EduardoLAV/Kinesic/README.md

# Kinesic
Platform to develop medical applications using biosignals

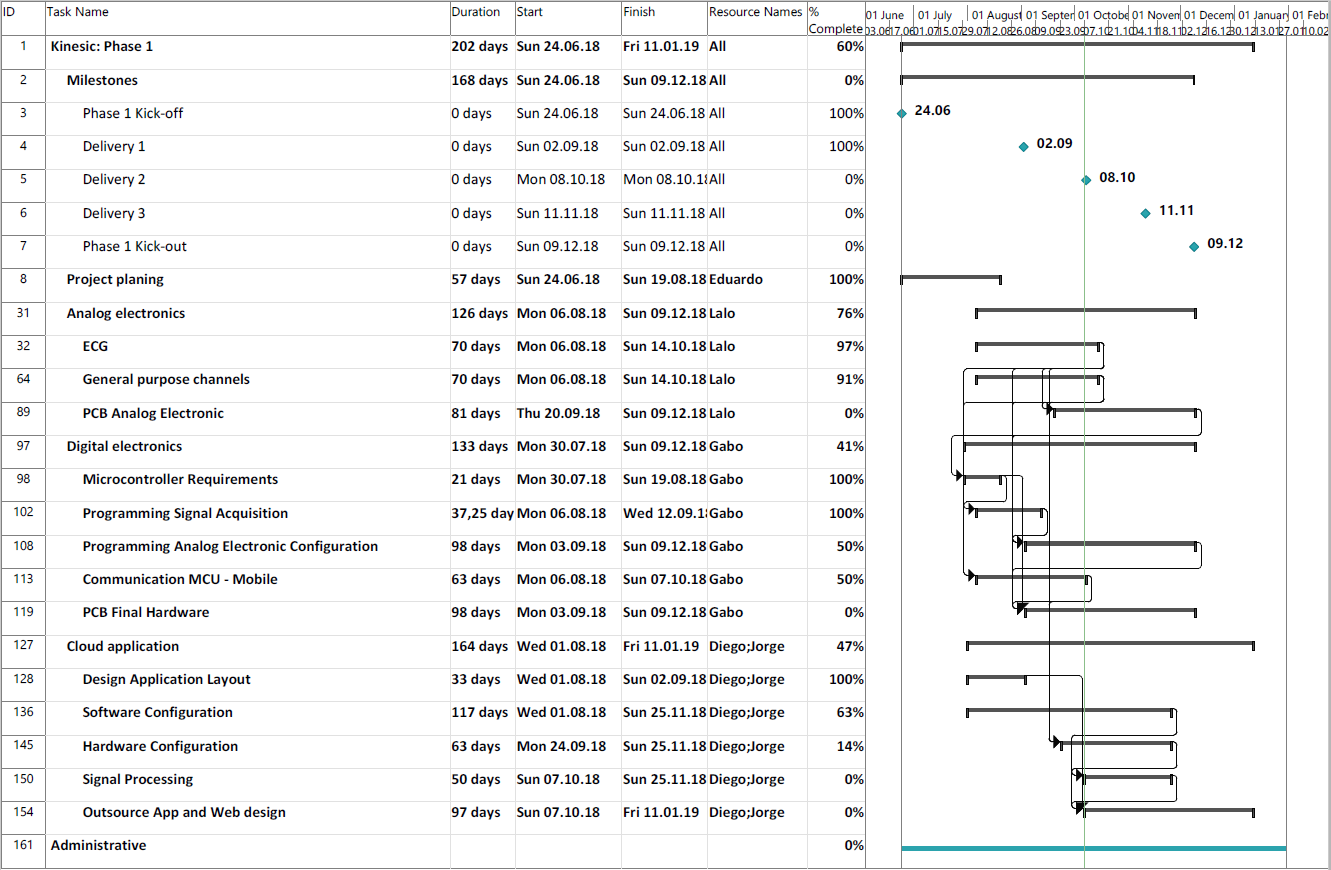
[picture p1: 10_Management/10_Planning/Kinesic_Timeline.PNG]
