EduardoLAV/Kinesic/20_Engineering/10_Analog_Electronics/Empresas PCB.docx

Nombre | Sitio Web | Localidad | Especificaciones de diseño | Formulario de cotización
Mextronics | mextronics.com | CDMX | liga (http://www.mextronics.com/index.php/produccion-de-pcb-s/especificaciones) | Mextronics cotización (http://www.mextronics.com/index.php/produccion-de-pcb-s/especificaciones)
Hetpro | hetpro-store.com | Guadalajara | Hetpro: - especificaciones (https://hetpro-store.com/fabricacionPCB/fabricacion-pcb-mexico/) - Diseño (https://hetpro-store.com/fabricacionPCB/fabricacion-pcb-mexico/) | Hetpro cotización (https://hetpro-store.com/fabricacionPCB/fabricacion-pcb-mexico/)
Grupo Gollet Electronics | gollet.com.mx | Guadalajara | | (01)(33) 3810-6501, 3810-6502, 3343 9945
PCB rápido | pcbrapido.com | Querétaro | PCBRápido (http://pcbrapido.com/producto/placa-intel/) | PCBR (http://pcbrapido.com/cotiza/)
Easy circuits | easycircuits.com.mx | CDMX
Tinxo electronic design | Tinxo.mx | Guadalajara | | Servicios (http://tinxo.mx/servicios/)
Electrónica estudio | electronicaestudio.com | CDMX | Servicios (http://www.electronicaestudio.com/ingenieria.htm)
