EduardoLAV/Kinesic/20_Engineering/10_Analog_Electronics/10_Planning/Gantt_Analog_Electronics.xlsx

ID | Task | Status | Start Date | Due Date | Duration | Y | 2018
 |  |  |  |  |  | M | Jun |  | Jul |  |  |  |  | Aug |  |  |  | Sep |  |  |  | Oct |  |  |  |  | Nov |  |  |  | Dec
 |  |  |  |  |  | CW | 25 | 26 | 27 | 28 | 29 | 30 | 31 | 32 | 33 | 34 | 35 | 36 | 37 | 38 | 39 | 40 | 41 | 42 | 43 | 44 | 45 | 46 | 47 | 48 | 49 | 50 | 51 | 52 | 53
2.1 | ECG
2.1.1 | Preamplification | Doing | 2018-08-06 | 2018-08-19 | 13
2.1.1.1 | Identify gain ranges for pre-amplification | Closed | 2018-08-06 | 2018-08-19 | 13
2.1.1.2 | Define instrumental amplifier to be used 12/08/2018: AD620 | Closed | 2018-08-06 | 2018-08-12 | 6
2.1.1.3 | Calculate needed ranges of digital potentiometers | Closed | 2018-08-06 | 2018-08-19 | 13
2.1.1.4 | Identify and buy digital potentiomet. and InsAmp. | Closed | 2018-08-06 | 2018-08-19 | 13
2.1.1.5 | Build preamplification circuit in protoboard | Closed | 2018-08-06 | 2018-08-19 | 13
2.1.1.6 | Test preamplification circuit | Open | 2018-09-13 | 2018-09-19 | 6
2.1.1.7 | Define final potentiomet. and InsAmp. to be used | Open | 2018-09-13 | 2018-09-19 | 6
2.1.2 | Multiplexer | Doing | 2018-09-03 | 2018-09-30 | 27
2.1.2.1 | Research types of analog multiplexers | Doing | 2018-09-01 | 2018-09-13 | 12
2.1.2.2 | Identify and order 3 analog multiplexers | Open | 2018-09-03 | 2018-09-15 | 12
2.1.2.3 | Receive multiplexer | Open | 2018-09-05 | 2018-09-17 | 12
2.1.2.4 | Build multiplexer + preamplification in protoboard | Open | 2018-09-08 | 2018-09-22 | 14
2.1.2.5 | Test signal quality with multiplexer | Open | 2018-09-18 | 2018-09-23 | 5
2.1.2.6 | Verify maximum signal frequency with multiplexer | Open | 2018-09-18 | 2018-09-23 | 5
2.1.2.7 | Define multiplexer to be used | Open | 2018-09-23 | 2018-09-30 | 7
2.1.3 | Filters | Doing | 2018-08-13 | 2018-09-30 | 48
2.1.3.1 | Identify frequency ranges for biosignals | Closed | 2018-08-13 | 2018-08-26 | 13
2.1.3.2 | Design cut-band filter at 60Hz | Closed | 2018-08-13 | 2018-08-26 | 13
2.1.3.3 | Identify and buy digital pot. for all frequency ranges | Closed | 2018-08-20 | 2018-09-02 | 13
2.1.3.4 | Build filter + multiplexer + preamp. in protoboard | Open | 2018-09-08 | 2018-09-22 | 14
2.1.3.5 | Test filters | Open | 2018-09-22 | 2018-09-25 | 3
2.1.3.6 | Define components for filter circuit | Open | 2018-09-24 | 2018-09-25 | 1
2.1.4 | Final Amplification | Open | 2018-09-10 | 2018-09-30 | 20
2.1.4.1 | Identify gain ranges for final amplification | Closed | 2018-09-10 | 2018-09-16 | 6
2.1.4.2 | Calculate needed ranges of digital potentiometers | Closed | 2018-09-10 | 2018-09-16 | 6
2.1.4.3 | Identify and buy digital potentiometers | Doing | 2018-09-10 | 2018-09-23 | 13
2.1.4.4 | Build amp+filter+multiplexer+preamp in protoboard | Open | 2018-09-24 | 2018-09-30 | 6
2.1.4.5 | Test amplification circuit | Open | 2018-09-24 | 2018-09-30 | 6
2.1.4.6 | Define digital potentiometers to be used | Open | 2018-09-24 | 2018-09-30 | 6
2.2 | General purpose channels
2.2.1 | Preamplification | Doing | 2018-08-06 | 2018-08-19 | 13
2.2.1.1 | Identify gain ranges for pre-amplification | Closed | 2018-08-06 | 2018-08-19 | 13
2.2.1.2 | Define instrumental amplifier to be used 12/08/2018: AD620 | Closed | 2018-08-06 | 2018-08-12 | 6
2.2.1.3 | Calculate needed ranges of digital potentiometers | Closed | 2018-08-06 | 2018-08-19 | 13
2.2.1.4 | Identify and buy digital potentiomet. and InsAmp. | Closed | 2018-08-06 | 2018-08-19 | 13
2.2.1.5 | Build preamplification circuit in protoboard | Closed | 2018-08-06 | 2018-08-19 | 13
2.2.1.6 | Test preamplification circuit | Open | 2018-09-08 | 2018-09-15 | 7
2.2.1.7 | Define final potentiomet. and InsAmp. to be used | Open | 2018-09-14 | 2018-09-16 | 2
2.2.2 | Filters | Doing | 2018-08-13 | 2018-09-30 | 48
2.2.2.1 | Identify frequency ranges for biosignals | Closed | 2018-08-13 | 2018-08-26 | 13
2.2.2.2 | Calculate ranges of digital pot. for low-pass filters | Doing | 2018-09-13 | 2018-09-12 | 0
2.2.2.3 | Calculate ranges of digital pot. for high-pass filters | Closed | 2018-08-13 | 2018-08-26 | 13
2.2.2.4 | Design cut-band filter at 60Hz | Closed | 2018-08-13 | 2018-08-26 | 13
2.2.2.5 | Identify and buy digital pot. for all frequency ranges | Doing | 2018-08-28 | 2018-09-15 | 18
2.2.2.6 | Build filter + multiplexer + preamp. in protoboard | Open | 2018-09-16 | 2018-10-05 | 19
2.2.2.7 | Test filters with different frequency ranges | Open | 2018-09-20 | 2018-10-06 | 16
2.2.2.8 | Define components for filter circuit | Open | 2018-10-05 | 2018-10-07 | 2
2.2.4 | Final Amplification | Open | 2018-09-10 | 2018-10-07 | 27
2.2.4.1 | Identify gain ranges for final amplification | Closed | 2018-09-10 | 2018-09-16 | 6
2.2.4.2 | Calculate needed ranges of digital potentiometers | Closed | 2018-09-10 | 2018-09-16 | 6
2.2.4.3 | Identify and buy digital potentiometers | Doing | 2018-09-10 | 2018-09-23 | 13
2.2.4.4 | Build amp+filter+multiplexer+preamp in protoboard | Open | 2018-09-24 | 2018-10-02 | 8
2.2.4.5 | Test amplification circuit | Open | 2018-09-24 | 2018-10-05 | 11
2.2.4.6 | Define digital potentiometers to be used | Open | 2018-09-24 | 2018-10-06 | 12
2.3 | PCB Analog Electronic | Open | 2018-09-03 | 2018-12-09 | 97
2.3.1 | Design PCB eschematics | Open | 2018-10-13 | 2018-10-19 | 6
2.3.2 | Create electronic/PCB layout | Open | 2018-10-20 | 2018-10-28 | 8
2.3.3 | Contact 5 suppliers to manufacture prototype | Open | 2018-09-20 | 2018-10-20 | 30
2.3.4 | Receive 3 RFQs | Open | 2018-10-01 | 2018-10-28 | 27
2.3.5 | Perform PO | Open | 2018-10-22 | 2018-11-18 | 27
2.3.6 | Receive PCB prototype | Open | 2018-11-19 | 2018-11-25 | 6
2.3.7 | Validate prototype | Open | 2018-11-26 | 2018-12-09 | 13
