EduardoLAV/Kinesic/20_Engineering/10_Analog_Electronics/Entrega/Sobre documentos de Eagle.docx

Sobre documentos de Eagle.

Se cargaron los documentos de los archivos Eagle en un Zip. En cada Zip se encuentran muchos archivos. El .sch corresponde al esquemático. El .brd, corresponde al board. Dichos documentos fueron creados en la versión 9.0.0 de Eagle, sin embargo, pueden ser utilizados en versiones posteriores.

Los documentos Eagle se dividen en dos opciones:

1. Opción de una sola placa 10x15 cm a doble cara.

Los archivos relacionados con este diseño son los que tienen por nombre “Placa 1”.

2. Opción de dos placas “Primera” y “Segunda”.

Primera: 10x10 cm, etapa de adquisición, amplificación diferencial y aislamiento.

Segunda: 10x15 cm, filtrado y amp. Variable

A parte de los zip, se subió un .pdf con los esquemáticos para poder visualizarlos en modo PDF.
