EduardoLAV/Kinesic/10_Management/50_Market/Statistics/global_medical_alert_market_2013_2020.pdf

M

ark

et v

olu

m

e in

billio

n

U.S. d

ollars

Global medical alert systems/PERS market volume between 2013 and 2020 (in billion U.S. dollars)*

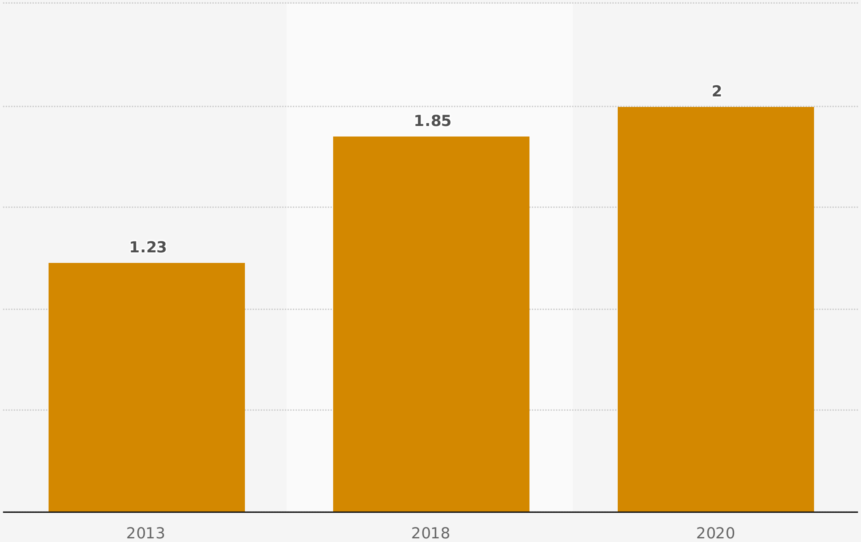
[picture p15: figure]

Additional Information:
Worldwide

Source
IndustryARC
© Statista 2018

0

0.5

1

1.5

2

2.5
