EduardoLAV/Kinesic/20_Engineering/20_Digital_Electronics/10_Planning/Gantt_Digital_Electronics.xlsx

ID | Task | Status | Start Date | Due Date | Duration | Y | 2018 |  |  |  |  |  |  |  |  |  |  |  |  |  |  |  |  |  |  |  |  |  |  |  |  |  |  |  |  | Open | 20 | 66.67%
 |  |  |  |  |  | M | Jun |  | Jul |  |  |  |  | Aug |  |  |  | Sep |  |  |  | Oct |  |  |  |  | Nov |  |  |  | Dec |  |  |  |  | Doing | 9 | 30.00%
 |  |  |  |  |  | CW | 25 | 26 | 27 | 28 | 29 | 30 | 31 | 32 | 33 | 34 | 35 | 36 | 37 | 38 | 39 | 40 | 41 | 42 | 43 | 44 | 45 | 46 | 47 | 48 | 49 | 50 | 51 | 52 | 53 | Closed | 1 | 3.33%
3. | Digital Electronics | Doing | 2018-07-30 | 2018-12-09 | 132
3.1 | Microcontroller Requirements | Doing | 2018-07-30 | 2018-08-19 | 20
3.1.1 | Define inputs needed for signal acquisition | Doing | 2018-08-06 | 2018-08-19 | 13
3.1.2 | Define outputs needed for digital potentiometers | Open | 2018-08-06 | 2018-08-19 | 13
3.1.3 | Decide on communication protocol - MCU & Mobile 12/08/2018: Bluetooth | Closed | 2018-07-30 | 2018-08-12 | 13
3.2 | Programming Signal Acquisition | Doing | 2018-08-06 | 2018-09-02 | 27
3.2.1 | Program signal acquisition in MCU | Doing | 2018-09-06 | 2018-09-12 | 6
3.2.2 | Design and implement signal validation tool | Open | 2018-08-06 | 2018-08-19 | 13
3.2.3 | Test signal acquisition by using standard signals | Open | 2018-08-13 | 2018-08-19 | 6
3.2.4 | Program signal acquisition using multiplexer | Open | 2018-08-13 | 2018-08-26 | 13
3.2.5 | Test signal acquisition by using standard signals | Open | 2018-08-27 | 2018-09-02 | 6
3.3 | Programming Analog Electronic Configuration | Doing | 2018-09-03 | 2018-12-09 | 97
3.3.1 | Set base config. for acquisition of standard signals | Doing | 2018-09-03 | 2018-09-30 | 27
3.3.2 | Test base configuration by using standard signals | Open | 2018-10-01 | 2018-10-07 | 6
3.3.3 | Test base config. with electronic from protoboard | Open | 2018-10-01 | 2018-10-07 | 6
3.3.4 | Test base config. with PCB analog electronic | Open | 2018-11-26 | 2018-12-09 | 13
3.4 | Communication MCU - Mobile | Doing | Doing | 2018-10-07 | #VALUE!
3.4.1 | Identify and order communication module | Doing | 2018-08-06 | 2018-08-19 | 13
3.4.2 | Program communication between MCU & Mobile | Open | 2018-08-13 | 2018-09-02 | 20
3.4.3 | Test communication by sending dummy sequences | Open | 2018-09-03 | 2018-09-16 | 13
3.4.4 | Test communication by sending known signal | Open | 2018-09-03 | 2018-09-16 | 13
3.4.5 | Test communication by sending biosignals | Open | 2018-10-01 | 2018-10-07 | 6
3.5 | PCB Final Hardware | Open | 2018-09-03 | 2018-12-09 | 97
3.5.1 | Select MCU that covers requirements | Open | 2018-09-03 | 2018-09-16 | 13
3.5.2 | Design PCB layout with analog electronics | Open | 2018-09-10 | 2018-10-14 | 34
3.5.3 | Contact 5 suppliers to manufacture prototype | Open | 2018-09-03 | 2018-09-30 | 27
3.5.4 | Receive 3 RFQs | Open | 2018-10-01 | 2018-10-28 | 27
3.5.5 | Perform PO | Open | 2018-10-22 | 2018-11-18 | 27
3.5.6 | Receive PCB prototype | Open | 2018-11-19 | 2018-11-26 | 7
3.5.7 | Validate prototype | Open | 2018-11-27 | 2018-12-09 | 12
