EduardoLAV/Kinesic/30_Supplier_Management/10_RFQ/README.md

Requests for quotation will be saved here independently of the application area: analog and digital electronics, web page, cloud application, etc.
