EduardoLAV/Kinesic/30_Supplier_Management/20_Quotes/README.md

Quotes received from suppliers to be saved here
