EduardoLAV/Kinesic/10_Management/20_Finance/10_Accounting/expense-tracking.xlsx

Sheet: Expenses
Expense Tracking
 |  |  |  |  |  |  |  |  | © 2009-2014 Vertex42 LLC
 |  | Budget |  |  |  |  |  | 31446.22 | https://www.vertex42.com/ExcelTemplates/expense-tracker.html
 |  | % Spent | - | - | - | - | - | 0.0%
 |  | Remaining | 0 | 0 | 0 | 0 | 0 | 31446.22
 |  |  |  |  |  |  |  | [42]
Date | Payment Type | Description | Analog Electronics | Digital Electronics | Interface MCU-Mobile | Cloud Solution | Other | Subtotal
 |  |  |  |  |  |  |  | 0.00
 |  |  |  |  |  |  |  | 0.00
 |  |  |  |  |  |  |  | 0.00
 |  |  |  |  |  |  |  | 0.00
 |  |  |  |  |  |  |  | 0.00
 |  |  |  |  |  |  |  | 0.00
 |  |  |  |  |  |  |  | 0.00
 |  |  |  |  |  |  |  | 0.00
 |  |  |  |  |  |  |  | 0.00
 |  |  |  |  |  |  |  | 0.00
 |  |  |  |  |  |  |  | 0.00
 |  |  |  |  |  |  |  | 0.00
 |  |  |  |  |  |  |  | 0.00
 |  |  |  |  |  |  |  | 0.00
 |  |  |  |  |  |  |  | 0.00
 |  |  |  |  |  |  |  | 0.00
 |  |  |  |  |  |  |  | 0.00
 |  |  |  |  |  |  |  | 0.00
 |  |  |  |  |  |  |  | 0.00
 |  |  |  |  |  |  |  | 0.00
 |  |  |  |  |  |  |  | 0.00
 |  |  |  |  |  |  |  | 0.00
 |  |  |  |  |  |  |  | 0.00
 |  |  |  |  |  |  |  | 0.00
 |  |  |  |  |  |  |  | 0.00
 |  |  |  |  |  |  |  | 0.00
 |  |  |  |  |  |  |  | 0.00
 |  |  |  |  |  |  |  | 0.00
 |  |  |  |  |  |  |  | 0.00
 |  |  |  |  |  |  |  | 0.00
 |  | Expense Total | 0.00 | 0.00 | 0.00 | 0.00 | 0.00 | 0.00

Sheet: ©
Expense Tracking Template
By Vertex42.com
https://www.vertex42.com/ExcelTemplates/expense-tracker.html
© 2009-2014 Vertex42 LLC
This spreadsheet, including all worksheets and associated content is a copyrighted work under the United States and other copyright laws.
Do not submit copies or modifications of this template to any website or online template gallery.
Please review the following license agreement to learn how you may or may not use this template. Thank you.
https://www.vertex42.com/licensing/EULA_privateuse.html
Do not delete this worksheet
