EduardoLAV/Kinesic/10_Management/50_Market/Statistics/ehealth_heart_failure_revenue_ww_2017.pdf

## Revenue of eHealth solutions for heart failure in selected countries worldwide in 2017* (in million U.S. dollars)

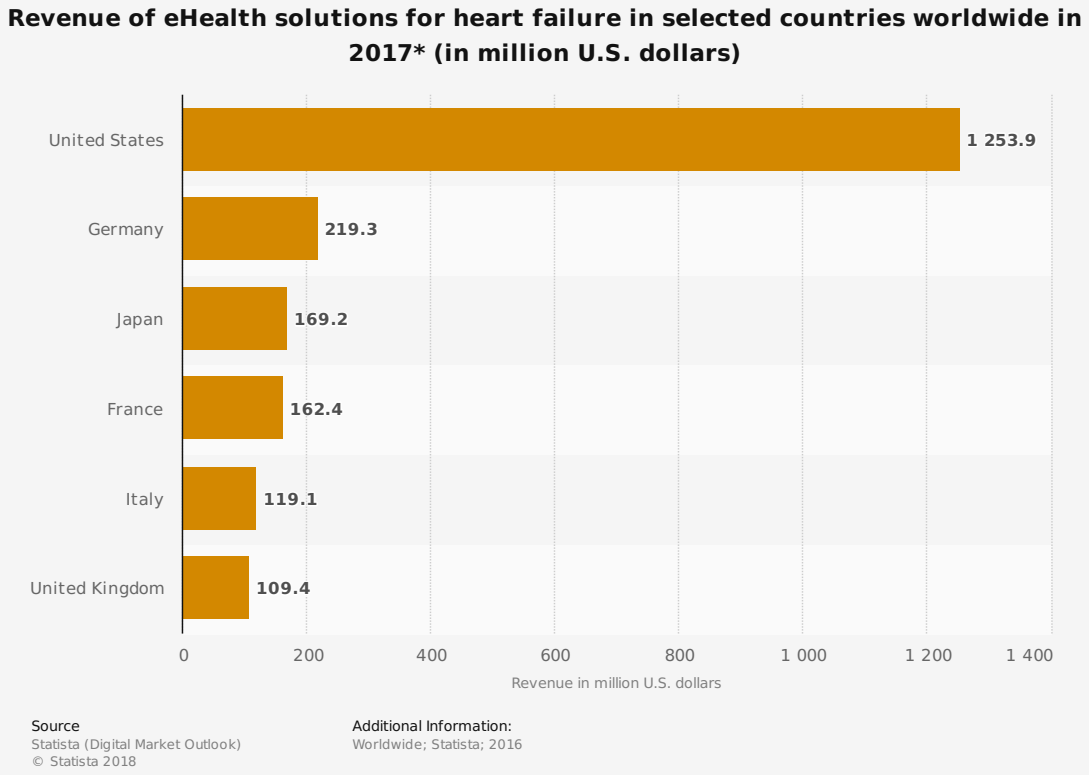
[picture p16: page 1]
Additional Information: Worldwide; Statista; 2016; United States; Germany; Japan; France; Italy; United Kingdom

Revenue in million U.S. dollars

Source
Statista (Digital Market Outlook)
© Statista 2018
