EduardoLAV/Kinesic/20_Engineering/10_Analog_Electronics/Entrega/Placa 1.pdf

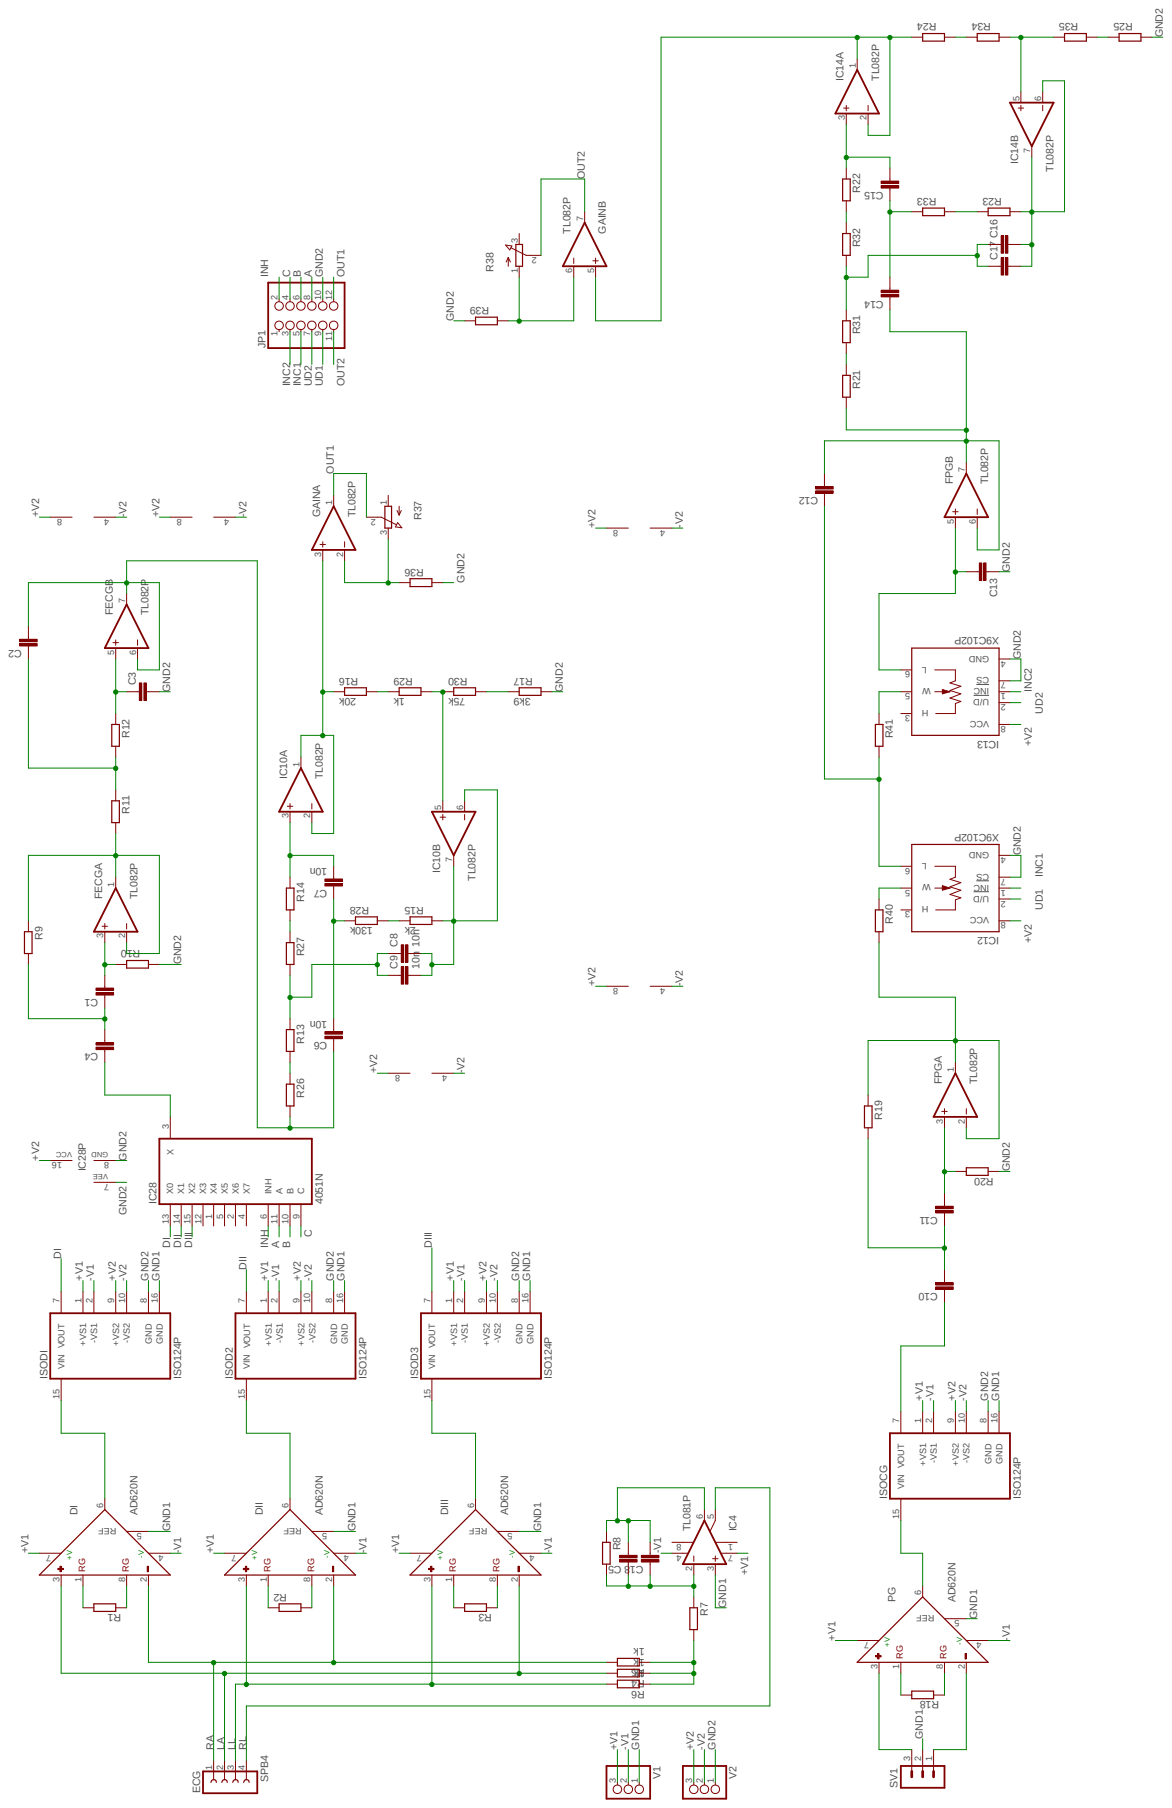
[picture p17: page 1]

1 R40 R41 JP11 2 3 4 5 6 7 8 9 10 11 12 C18 RALLRL GND1 GND1 GND1 GND1 GND1 GND1 GND1 GND1 GND1 GND1 GND1 GND2 GND2 GND2 GND2 GND2 GND2 GND2 GND2 GND2 GND2 GND2 GND2 GND2 GND2 GND2 GND2 GND2 GND2 +V1 +V1 +V1 +V1 +V1 +V1 +V1 +V1 +V1 +V1 -V1 -V1 -V1 -V1 -V1 -V1 -V1 -V1 -V1 -V1 +V2 +V2 +V2 +V2 +V2 +V2 +V2 +V2 +V2 +V2 +V2 +V2 +V2 -V2 -V2 -V2 -V2 -V2 -V2 -V2 -V2 -V2 -V2 DIDI DII DII DIII DIII LA OUT1 OUT1 OUT2 UD1 OUT2 UD1 UD2 UD2 INC1 INC1

A INH INH INC2 INC2 RGRGRGRGRGRG RGRG +V-V+V-V+V-V +V-V
