EduardoLAV/Kinesic/20_Engineering/10_Analog_Electronics/Entrega/Primera_pdf.pdf

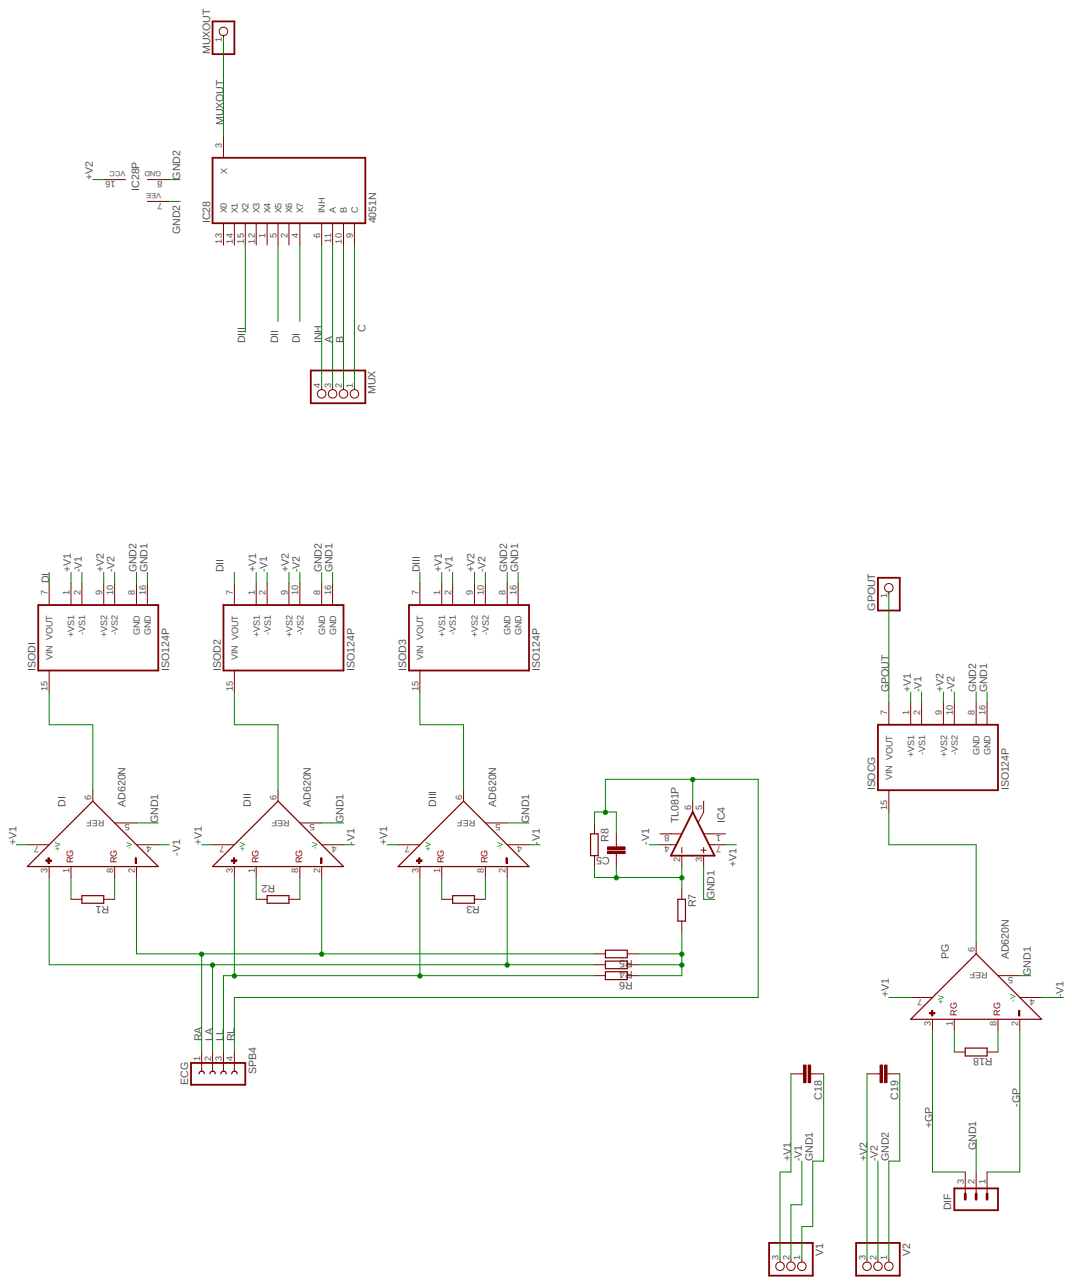
[picture p18: page 1]
AD620N AD620N AD620N TL081P ISO124P ISO124P ISO124P SPB4 AD620N ISO124P 4051N DI 3; 8 REF 5 DII 3; 8 REF 5 DIII 3; 8 REF 5 IC45; 9 -VS2 10 GND; 8 GND 16; 8 GND 16 IC28X4 1 X6; 5 INH; 9 B 10 A 11 X3 12 X0 13 X1 14 X2 15 DIF; 1 MUX 4; C INH

B GPOUT MUXOUT RGRGRGRGRGRG RGRG +V-V+V-V+V-V +V-V

1 GPOUT 1 RALLRL GND1 GND1 GND1 GND1 GND1 GND1 GND1 GND1 GND1 GND1 GND1 GND2 GND2 GND2 GND2 GND2 GND2 GND2 +V1 +V1 +V1 +V1 +V1 +V1 +V1 +V1 +V1 +V1 -V1-V1 -V1 -V1 -V1 -V1 -V1 -V1 -V1 -V1 +V2 +V2 +V2 +V2 +V2 +V2 -V2 -V2 -V2 -V2 -V2 DI DI DII DII DIII DIII LA +GP-GP

8 GND 16 ISOD2 VIN 15 VOUT

8 GND 16 ISOD3 VIN 15 VOUT

8 REF 5 R18 ISOCG VIN 15 VOUT
