EduardoLAV/Kinesic/20_Engineering/10_Analog_Electronics/Entrega/Segunda_pdf.pdf

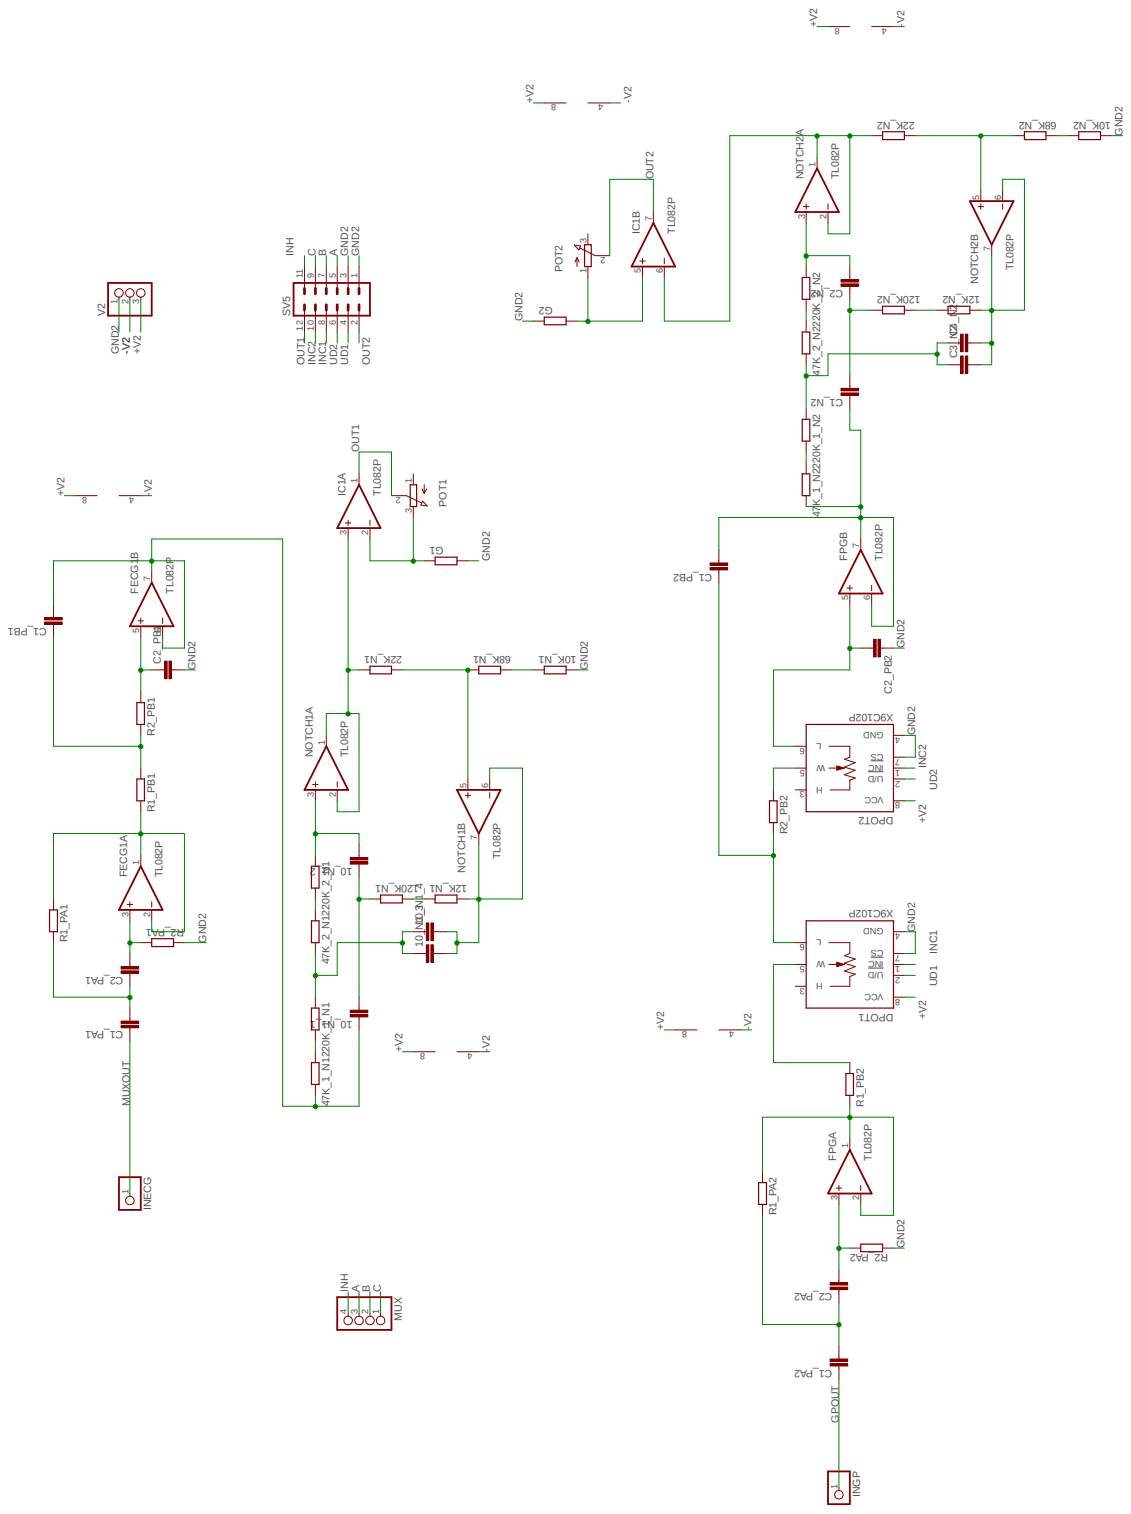
[picture p19: page 1]
C2_PA1 C1_PB1 C2_PB1 C1_PA1 R1_PA1 R2_PA1R1_PB1 R2_PB1 FECG1A 32 1 FECG1B 56 7 NOTCH1A 32 1 NOTCH1B 56 7 8 4 8 4 220K_1_N1 220K_2_N1 10_N1_1; 68K_N1 G1 POT11 3 2 SV5 531 642 1197 81210; C1_PA2 C2_PA2 FPGA 32 1 FPGB 56 7 8 4 R1_PA2 R2_PA2; C1_PB2 C2_PB2 DPOT1 U/D 2

68K_N2 POT2 1 3 2 G2 R1_PB2 R2_PB2 V2123 INECG1 INGP 1 MUX 4321 IC1A 32 1 IC1B 56 7 8 4 GND2 GND2 GND2 GND2 GND2 GND2 GND2 GND2 GND2 GND2 GND2 GND2 GND2 +V2 +V2 +V2 +V2+V2 +V2 +V2 +V2 -V2 -V2 -V2 -V2 -V2 -V2 MUXOUT OUT1 OUT1 OUT2 OUT2 UD1 UD1 UD2 UD2 INC1 INC1 C C B B A A INH INH INC2 INC2 GPOUT

INC 1 CS 7 VCC 8 GND 4 H 3 W 5 L 6NOTCH2A 32 1 NOTCH2B 56 7 8 4 47K_1_N2 220K_2_N2 C1_N2 C2_N2 C4_N2 C3_N2

INC 1 CS 7 VCC 8 GND 4 H 3 W 5 L 6 DPOT2 U/D 2
