EduardoLAV/Kinesic/10_Management/50_Market/Statistics/ehealth_revenue_EU_2018.pdf

## eHealth revenue in selected European countries in 2018 (in million U.S. dollars)

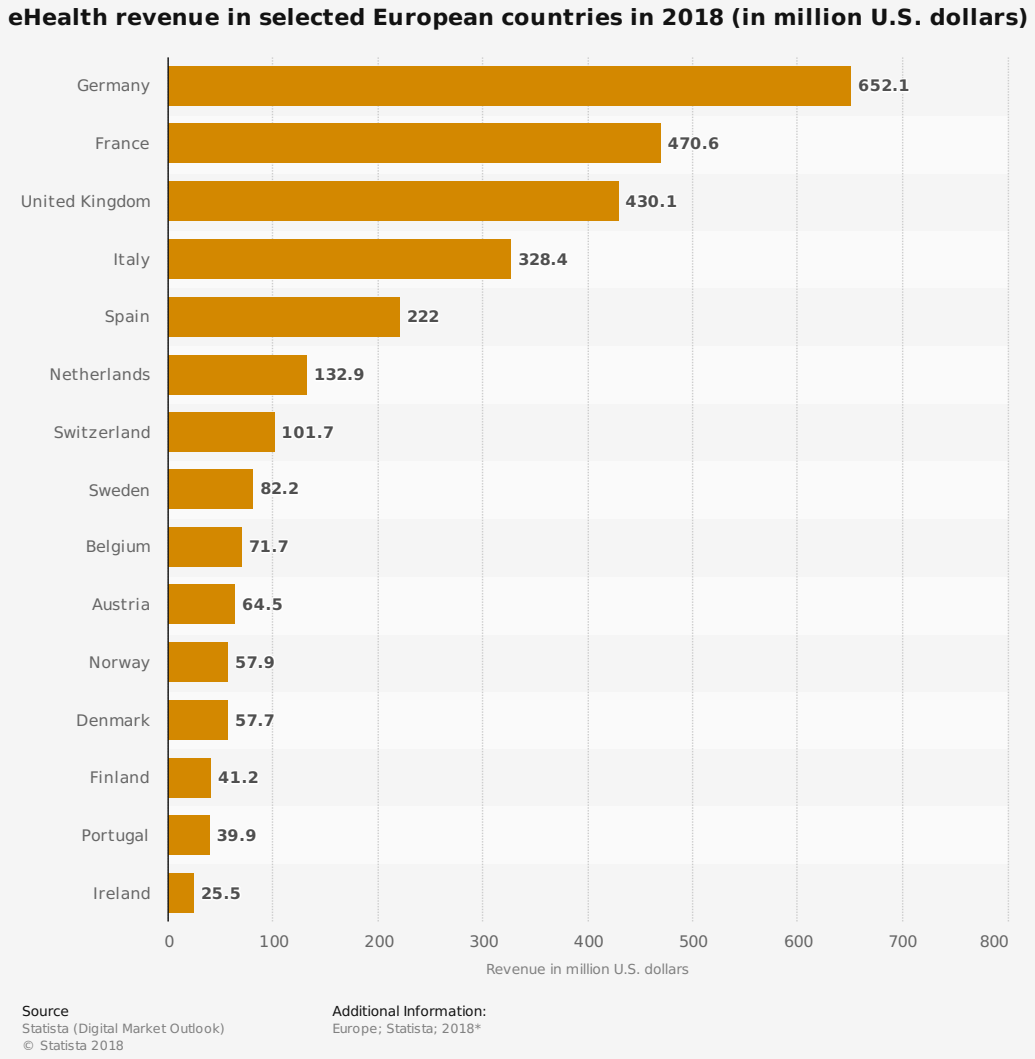
[picture p20: page 1]
Additional Information: Europe; Statista; 2018*; Germany; France; United Kingdom; Italy; Spain; Netherlands; Switzerland; Sweden; Belgium; Austria; Norway; Denmark; Finland; Portugal; Ireland

Revenue in million U.S. dollars

Source
Statista (Digital Market Outlook)
© Statista 2018
