EduardoLAV/Kinesic/10_Management/50_Market/Statistics/global_mhealth_devices_and_services_revenue_2014_2020.pdf

35.8

# Projected total global mHealth devices and services revenue from 2014 to 2020

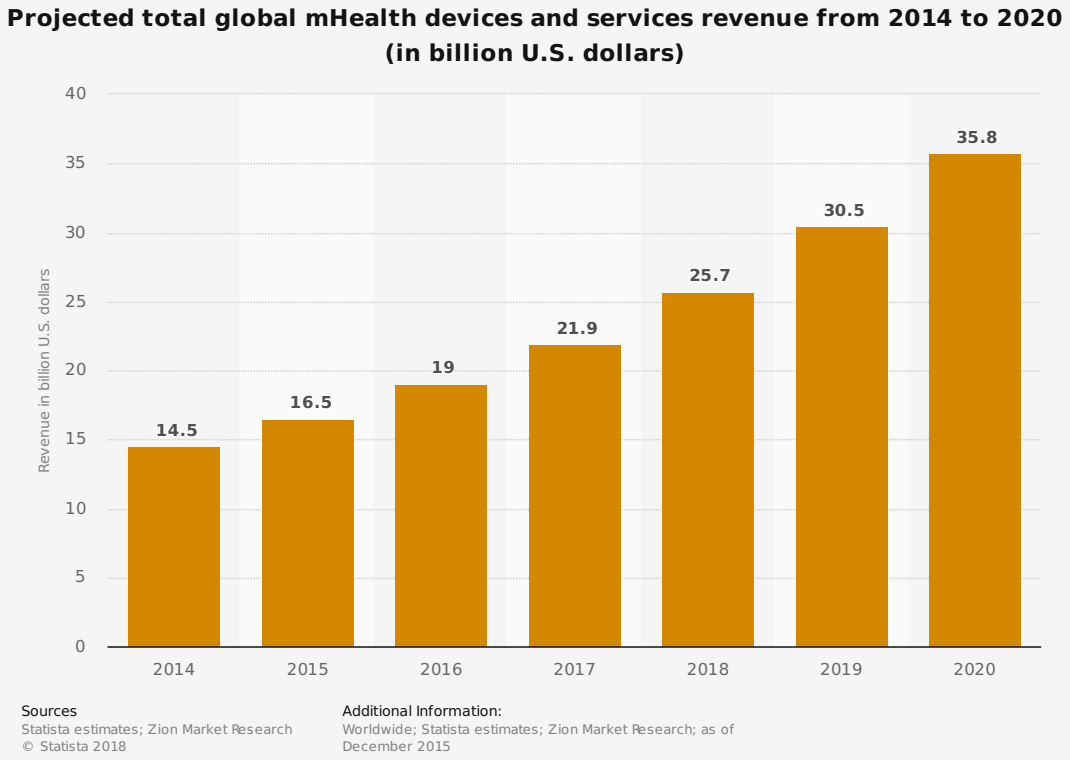
[picture p21: page 1]
billio; ollars

(in billion U.S. dollars)

Sources
Statista estimates; Zion Market Research
© Statista 2018

Additional Information:
Worldwide; Statista estimates; Zion Market Research; as of
December 2015
