EduardoLAV/Kinesic/10_Management/50_Market/Statistics/revenue_digital_health_startups_EU_2016.pdf

## Share of digital health startups revenues in the European Union in 2016

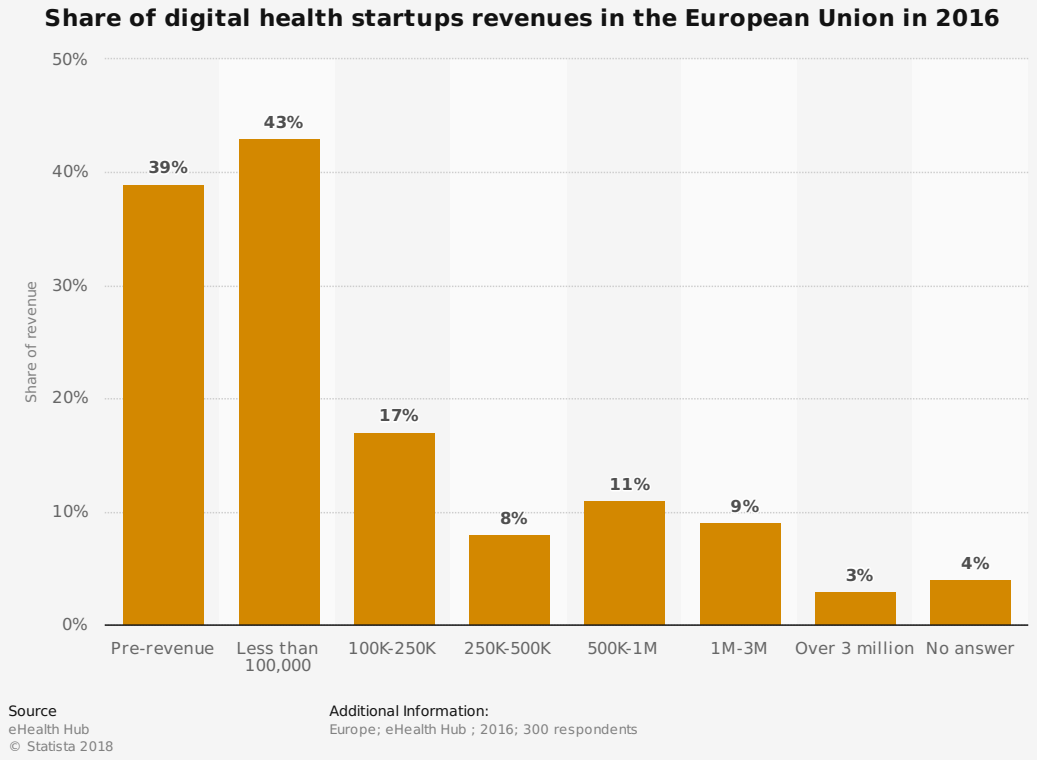
[picture p22: page 1]
are; Over 3 million No answer; Source eHealth Hub © Statista 2018

Pre-revenue Less than

Additional Information:
Europe; eHealth Hub ; 2016; 300 respondents
