EduardoLAV/Kinesic/10_Management/50_Market/Statistics/ehealth_heart-failure_penetration_EU_2016.pdf

## Usage penetration of eHealth solutions for heart failure in European countries in

2016

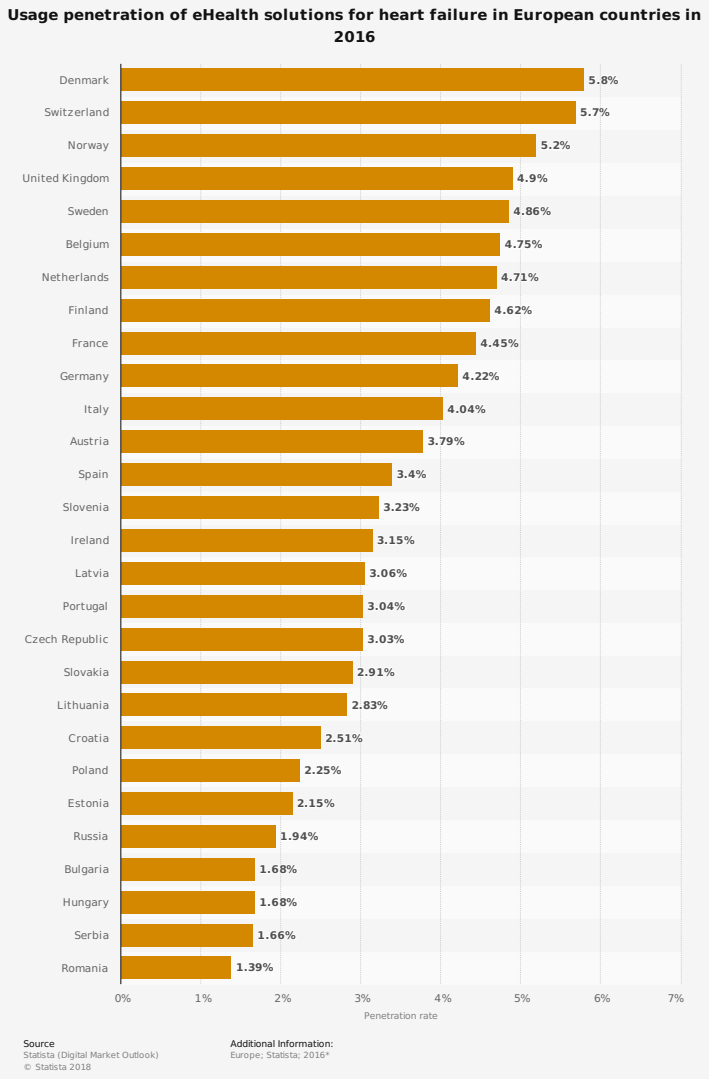
[picture p23: page 1]
Penetration rate; Additional Information: Europe; Statista; 2016*; Denmark; Switzerland; Norway; United Kingdom; Sweden; Belgium; Netherlands; Finland; France; Germany; Italy; Austria; Spain; Slovenia; Ireland; Latvia; Portugal; Czech Republic; Slovakia; Lithuania; Croatia; Poland; Estonia; Russia; Bulgaria; Hungary; Serbia; Romania

Source
Statista (Digital Market Outlook)
© Statista 2018
