EduardoLAV/Kinesic/10_Management/10_Planning/Kinesic_Timeline.pdf

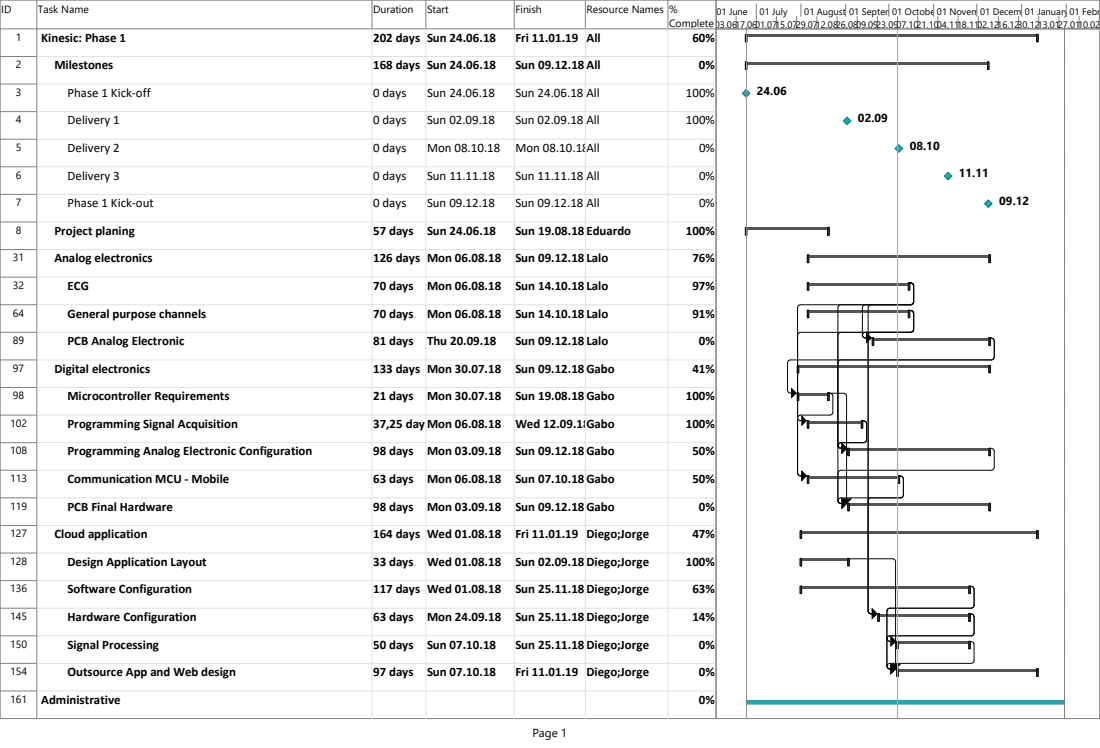
[picture p24: page 1]
01 June; 01 July; 01 August 01 September 01 October01 November 01 December 01 January01 February; Page 1

ID | Task Name | Duration | Start | Finish | Resource Names | % Complete
1 | Kinesic: Phase 1 | 202 days | Sun 24.06.18 | Fri 11.01.19 | All | 60%
2 | Milestones | 168 days | Sun 24.06.18 | Sun 09.12.18 All | | 0%
3 | Phase 1 Kick-off | 0 days | Sun 24.06.18 | Sun 24.06.18 All | | 100%
4 | Delivery 1 | 0 days | Sun 02.09.18 | Sun 02.09.18 All | | 100%
5 | Delivery 2 | 0 days | Mon 08.10.18 | Mon 08.10.18All | | 0%
6 | Delivery 3 | 0 days | Sun 11.11.18 | Sun 11.11.18 All | | 0%
7 | Phase 1 Kick-out | 0 days | Sun 09.12.18 | Sun 09.12.18 All | | 0%
8 | Project planing | 57 days | Sun 24.06.18 | Sun 19.08.18 Eduardo | | 100%
31 | Analog electronics | 126 days | Mon 06.08.18 | Sun 09.12.18 Lalo | | 76%
32 | ECG | 70 days | Mon 06.08.18 | Sun 14.10.18 Lalo | | 97%
64 | General purpose channels | 70 days | Mon 06.08.18 | Sun 14.10.18 Lalo | | 91%
89 | PCB Analog Electronic | 81 days | Thu 20.09.18 | Sun 09.12.18 Lalo | | 0%
97 | Digital electronics | 133 days | Mon 30.07.18 | Sun 09.12.18 Gabo | | 41%
98 | Microcontroller Requirements | 21 days | Mon 30.07.18 | Sun 19.08.18 Gabo | | 100%
102 | Programming Signal Acquisition | 37,25 daysMon 06.08.18 | | Wed 12.09.18Gabo | | 100%
108 | Programming Analog Electronic Configuration | 98 days | Mon 03.09.18 | Sun 09.12.18 Gabo | | 50%
113 | Communication MCU - Mobile | 63 days | Mon 06.08.18 | Sun 07.10.18 Gabo | | 50%
119 | PCB Final Hardware | 98 days | Mon 03.09.18 | Sun 09.12.18 Gabo | | 0%
127 | Cloud application | 164 days | Wed 01.08.18 | Fri 11.01.19 | Diego;Jorge | 47%
128 | Design Application Layout | 33 days | Wed 01.08.18 | Sun 02.09.18 Diego;Jorge | | 100%
136 | Software Configuration | 117 days | Wed 01.08.18 | Sun 25.11.18 Diego;Jorge | | 63%
145 | Hardware Configuration | 63 days | Mon 24.09.18 | Sun 25.11.18 Diego;Jorge | | 14%
150 | Signal Processing | 50 days | Sun 07.10.18 | Sun 25.11.18 Diego;Jorge | | 0%
154 | Outsource App and Web design | 97 days | Sun 07.10.18 | Fri 11.01.19 | Diego;Jorge | 0%
161 | Administrative | | | | | 0%
