EduardoLAV/Kinesic/10_Management/50_Market/Statistics/e-health_services_us_adults_would_be_willing_to_pay_2017.pdf

## E-health services Americans would be willing to pay for as of 2017

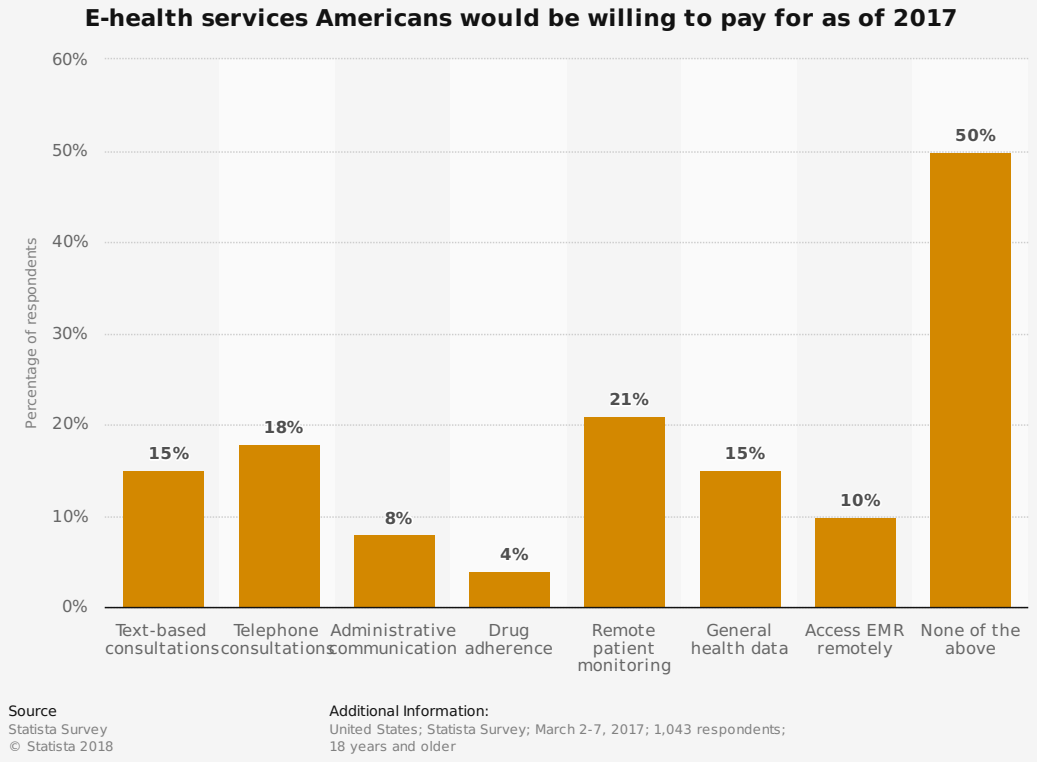
[picture p25: page 1]
erc; nta; nts; Text-based consultations; Telephone consultations; Administrative communication; Drug adherence; Remote patient monitoring; General health data; Access EMR remotely; Source Statista Survey © Statista 2018

None of the
above

Additional Information:
United States; Statista Survey; March 2-7, 2017; 1,043 respondents;
18 years and older
