EduardoLAV/Kinesic/10_Management/50_Market/Statistics/global_mobile_health_app_downloads_2013_2017.pdf

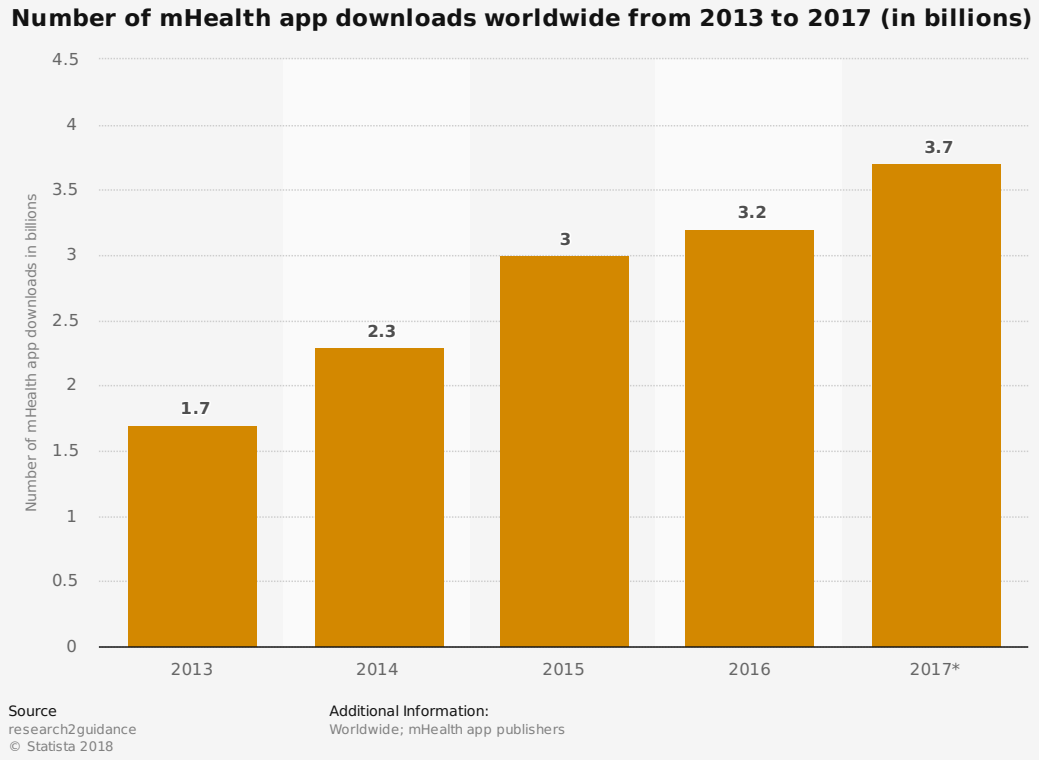
[picture p26: page 1]
alth; nlo; billio; Source research2guidance © Statista 2018

Number of mHealth app downloads worldwide from 2013 to 2017 (in billions)

Additional Information:
Worldwide; mHealth app publishers
