EduardoLAV/Kinesic/10_Management/50_Market/Statistics/us_adults_who_ever_heard_about_e_health_2017.pdf

## Percentage of U.S. adults who have ever heard about e-health as of 2017

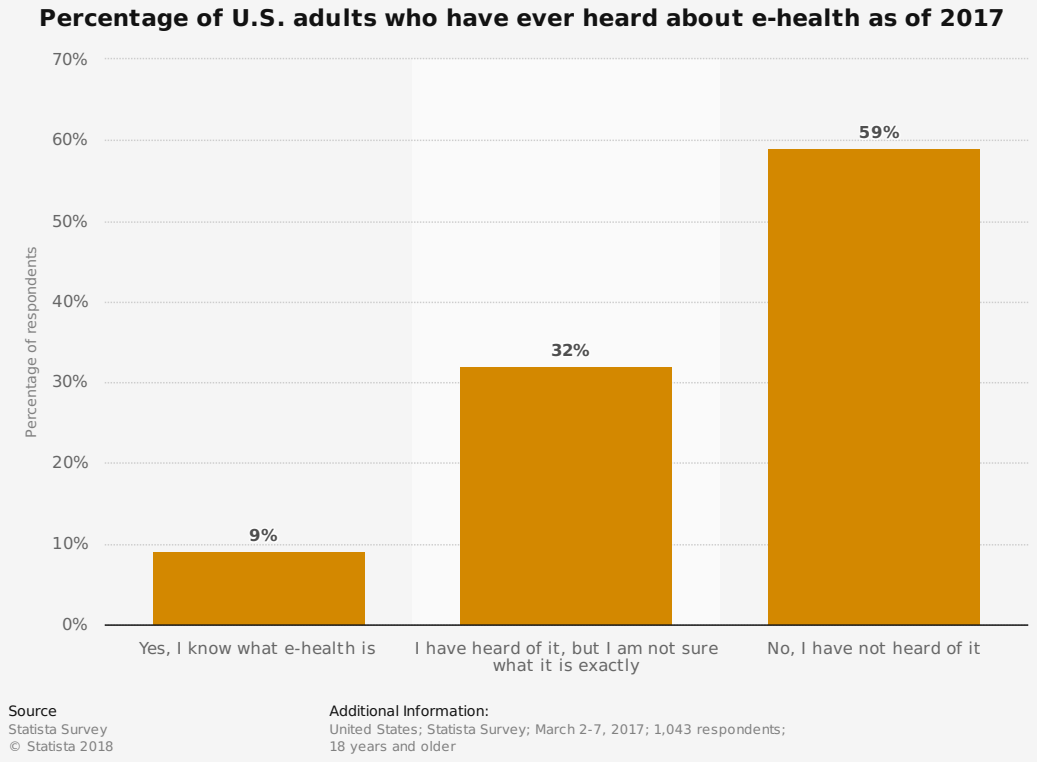
[picture p27: page 1]
erc; nta; nts; Yes, I know what e-health is; I have heard of it, but I am not sure; Source Statista Survey © Statista 2018

No, I have not heard of it

what it is exactly

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
