EduardoLAV/Kinesic/(list of files, drawings)

Other design files:
20_Engineering/10_Analog_Electronics/Entrega/Filtros Kinesic.ms14
