EduardoLAV/Kinesic/(commit log)

2018-09-23 Add files from old repo
    Add files in new structure and new repo
    [Gantt_Analog_Electronics.xlsx, Gantt_Cloud_Application.xlsx, Gantt_Digital_Electronics.xlsx, Project_Management.xlsx, expense-tracking.xlsx]
2018-09-23 Typo fixed in folder
    Typo fixed in folder's name: Analog_Electronics
    [Gantt_Analog_Electronics.xlsx]
2018-10-10 Journal article on IoT Healthcare
    Cognitive IoT-Cloud Integration for Smart Healthcare: Case Study for Epileptic Seizure Detection and Monitoring
2018-10-11 Market analysis and strategy
    Create folder for market analysis and strategy
    [Kinesic_Business Canvas.xlsx]
